RolandThsive/Solder-Fume-Extractor/Documentations/dc_jack.jpg

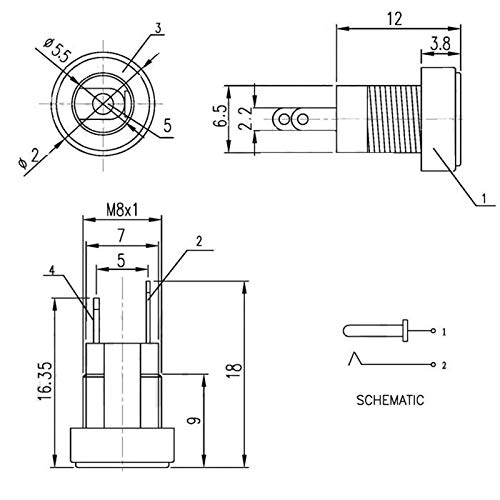
Documentations/dc_jack.jpg
