RolandThsive/Solder-Fume-Extractor/Documentations/dc_jack_5d5_2d5.jpg

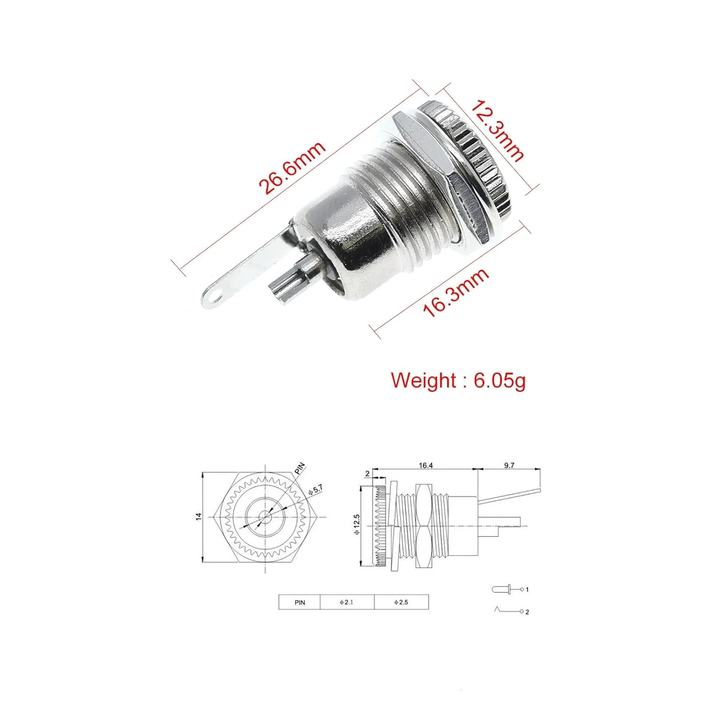
Documentations/dc_jack_5d5_2d5.jpg
