RolandThsive/Solder-Fume-Extractor/Pictures/Showcasing/01_cover.png

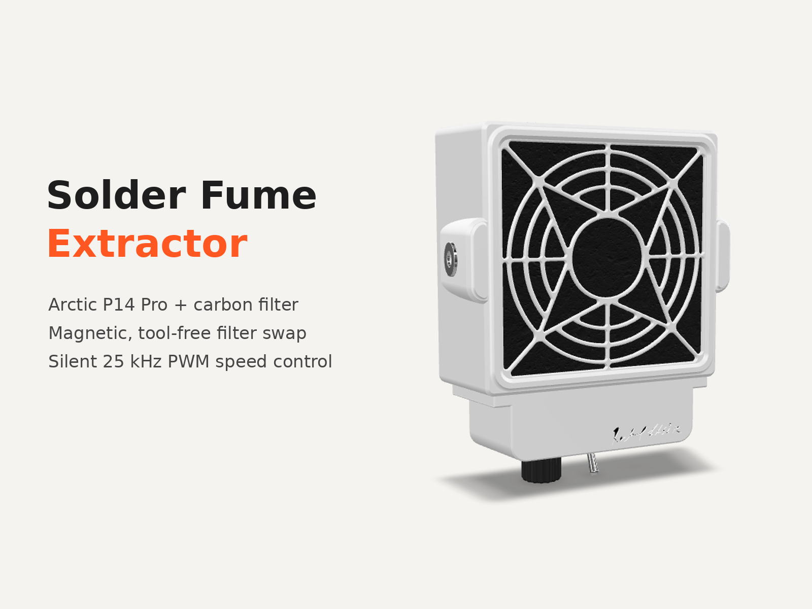
Pictures/Showcasing/01_cover.png
