RolandThsive/Solder-Fume-Extractor/Pictures/Showcasing/01_cover_3x4.png

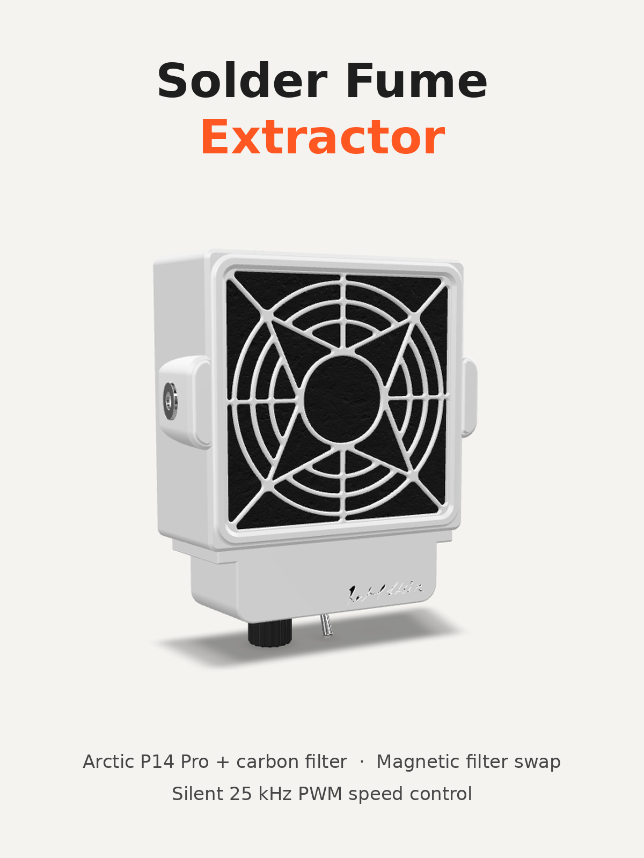
Pictures/Showcasing/01_cover_3x4.png
