RolandThsive/Solder-Fume-Extractor/Pictures/Showcasing/03_main_body.png

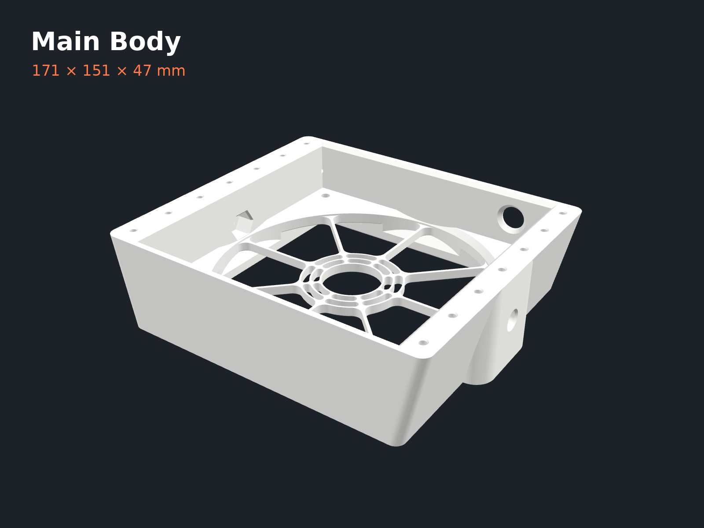
Pictures/Showcasing/03_main_body.png
