RolandThsive/Solder-Fume-Extractor/Pictures/Showcasing/04_back_cover.png

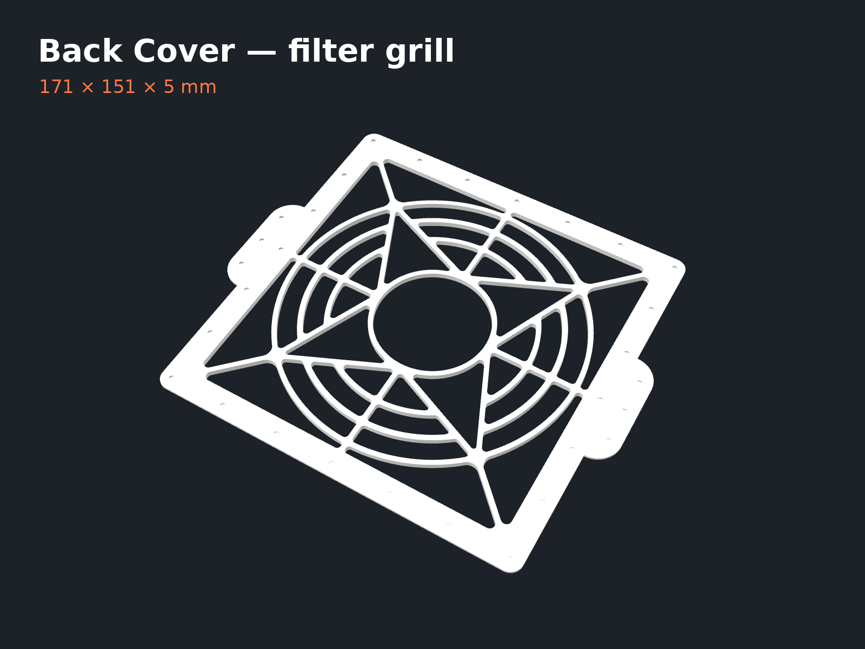
Pictures/Showcasing/04_back_cover.png
