RolandThsive/Solder-Fume-Extractor/Pictures/Showcasing/05_back_plate.png

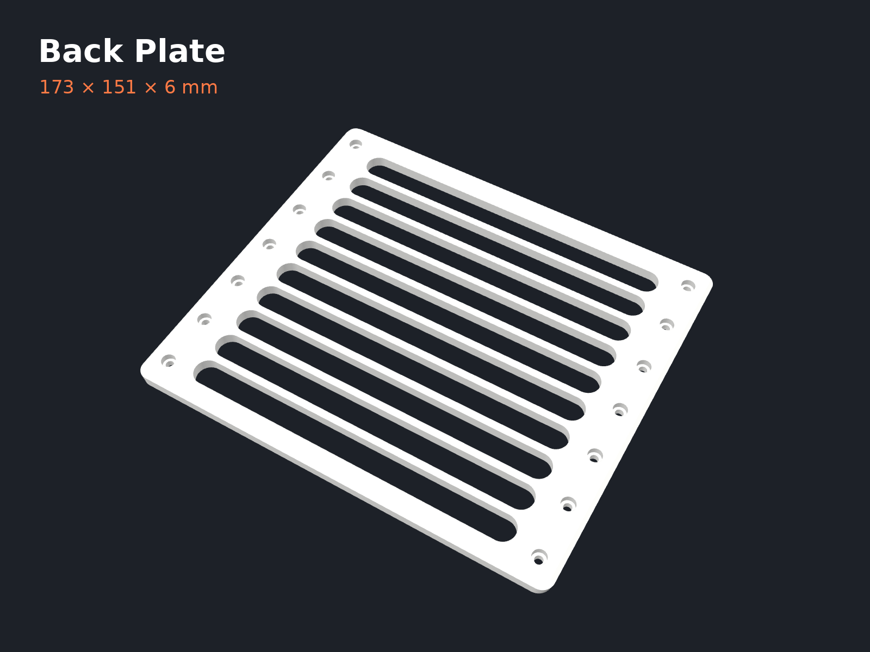
Pictures/Showcasing/05_back_plate.png
