RolandThsive/Solder-Fume-Extractor/Pictures/Showcasing/06_electronics_housing.png

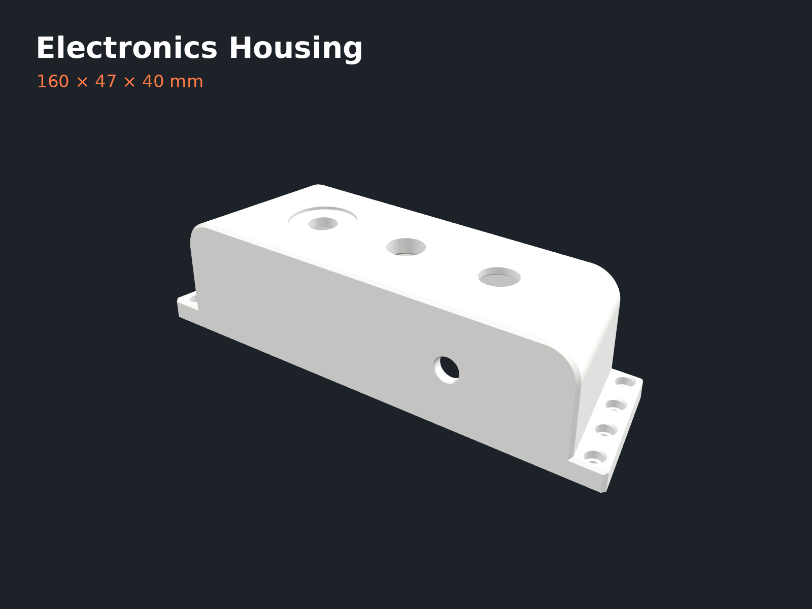
Pictures/Showcasing/06_electronics_housing.png
