RolandThsive/Solder-Fume-Extractor/Pictures/Showcasing/07_pot_knob.png

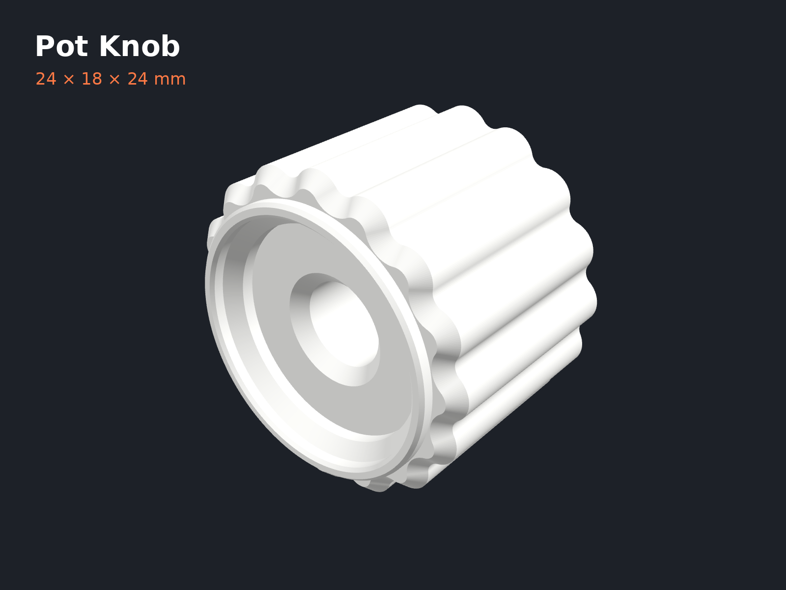
Pictures/Showcasing/07_pot_knob.png
