RolandThsive/Solder-Fume-Extractor/Pictures/Showcasing/08_stand_concept1.png

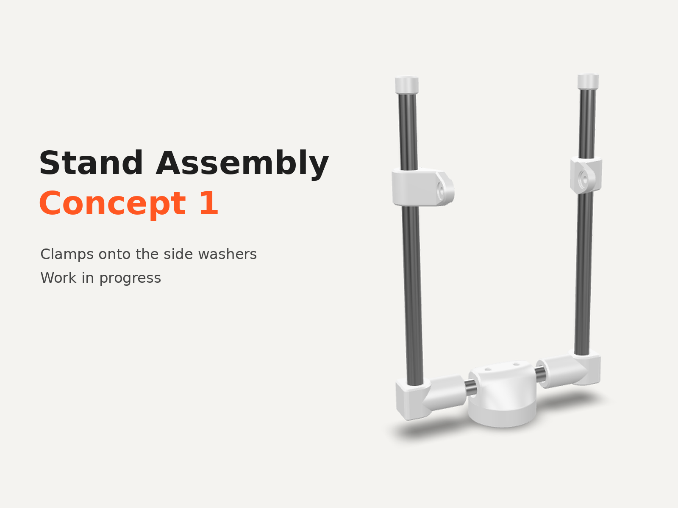
Pictures/Showcasing/08_stand_concept1.png
