RolandThsive/Solder-Fume-Extractor/Pictures/Showcasing/02_parts_overview.png

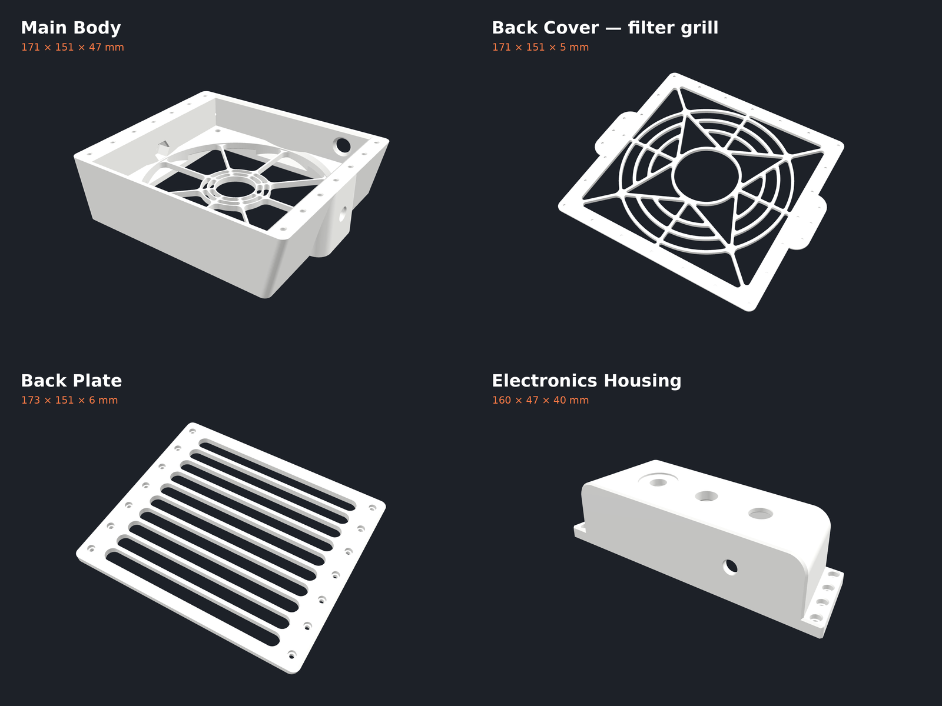
Pictures/Showcasing/02_parts_overview.png
