RolandThsive/Solder-Fume-Extractor/CAD/Solder Fume Extractor CAD/Steps/Solder Fume Extractor Without Stand/Complete Step File/SolderFumeExtractor_completeASM.step

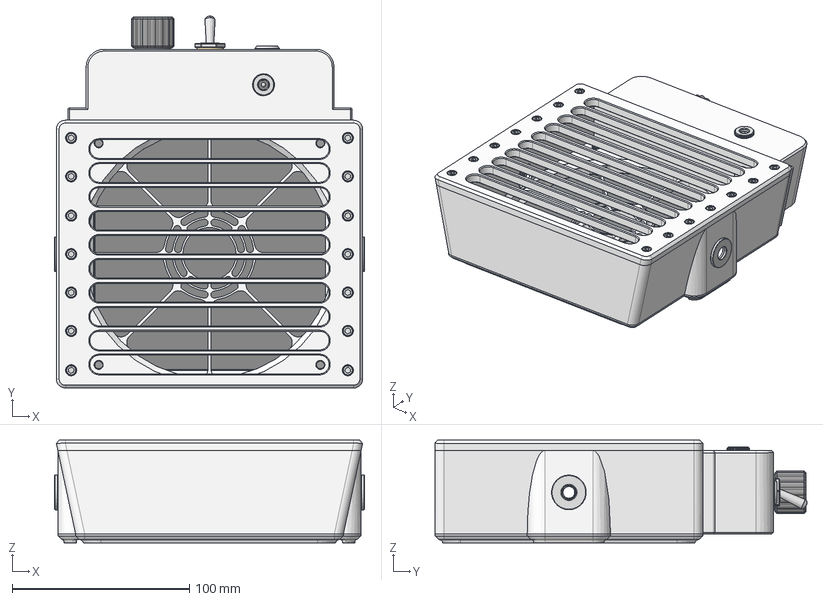
[picture p14: CAD file, 2026-10-24]
CAD/Solder Fume Extractor CAD/Steps/Solder Fume Extractor Without Stand/Complete Step File/SolderFumeExtractor_completeASM.step
175.0 x 209.8 x 58.0 mm
carbon_filter
3_x_10_allen_bolt x 14
back_plate
4mm_1d5_neodynium x 30
back_cover
4mm_4mm_neodynium_magnet x 30
m8_washer x 2
m3_nut x 14
fan_screw x 4
ecrou_m8 x 2
main_body
pot_knob
3_x_8_allen_bolt x 8
washer_12mm
3x5_m3_terminal x 3
m12x0_75_nut
plastic_housing
board
switch_lever
metal_body
the_terminal_pin
top_part_v2
nut_m11x0_75
housing
pin2_1
ring
pin1_2_5_
m10nut
threads
pin3
pin1
shaft
pin2
m10_washer
