RolandThsive/Solder-Fume-Extractor/CAD/Solder Fume Extractor CAD/Steps/Solder Fume Extractor Without Stand/Unique Files/fume_extractor_complete_asm - 4mm_4mm_neodynium_magnet (26).step

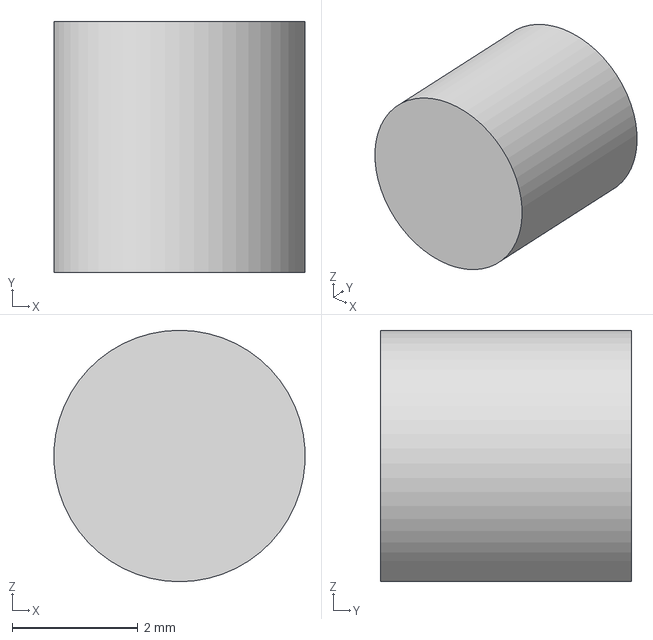
[picture p15: CAD file, 2026-10-24]
CAD/Solder Fume Extractor CAD/Steps/Solder Fume Extractor Without Stand/Unique Files/fume_extractor_complete_asm - 4mm_4mm_neodynium_magnet (26).step
3.99 x 4.00 x 4.00 mm
