RolandThsive/Solder-Fume-Extractor/CAD/Solder Fume Extractor CAD/STLs/main_body.stl

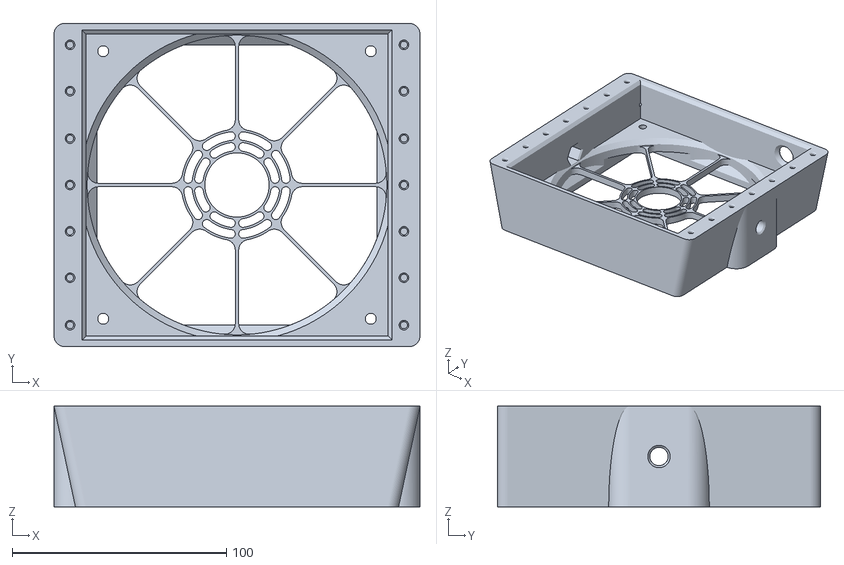
[picture p16: CAD file, 2026-10-24]
CAD/Solder Fume Extractor CAD/STLs/main_body.stl
171.0 x 151.0 x 47.0
