RolandThsive/Solder-Fume-Extractor/CAD/Solder Fume Extractor CAD/Steps/Solder Fume Extractor Without Stand/Unique Files/fume_extractor_complete_asm - 4mm_1d5_neodynium (11).step

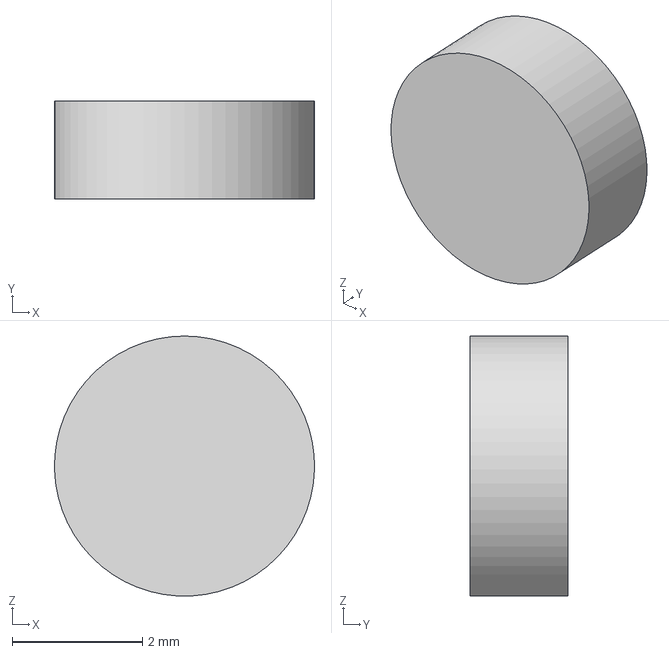
[picture p17: CAD file, 2026-10-24]
CAD/Solder Fume Extractor CAD/Steps/Solder Fume Extractor Without Stand/Unique Files/fume_extractor_complete_asm - 4mm_1d5_neodynium (11).step
4.00 x 1.50 x 4.00 mm
