RolandThsive/Solder-Fume-Extractor/CAD/Solder Fume Extractor CAD/Steps/Solder Fume Extractor Without Stand/Unique Files/fume_extractor_complete_asm - back_plate.step

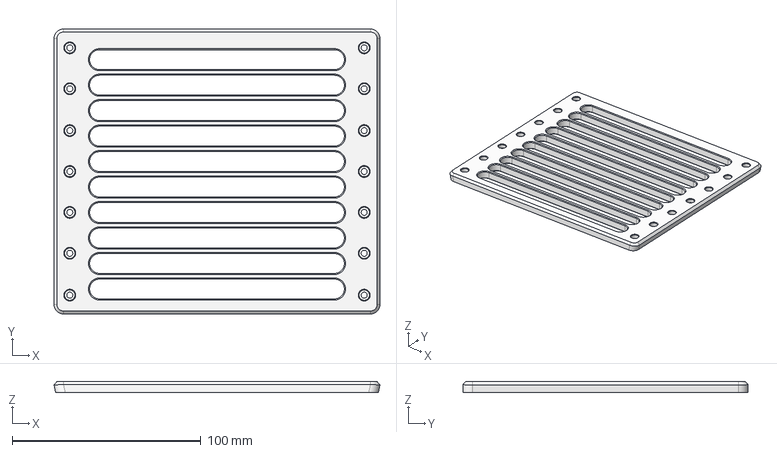
[picture p18: CAD file, 2026-10-24]
CAD/Solder Fume Extractor CAD/Steps/Solder Fume Extractor Without Stand/Unique Files/fume_extractor_complete_asm - back_plate.step
172.7 x 151.0 x 6.00 mm
