RolandThsive/Solder-Fume-Extractor/CAD/Solder Fume Extractor CAD/Steps/Solder Fume Extractor Without Stand/Unique Files/fume_extractor_complete_asm - switch_lever.step

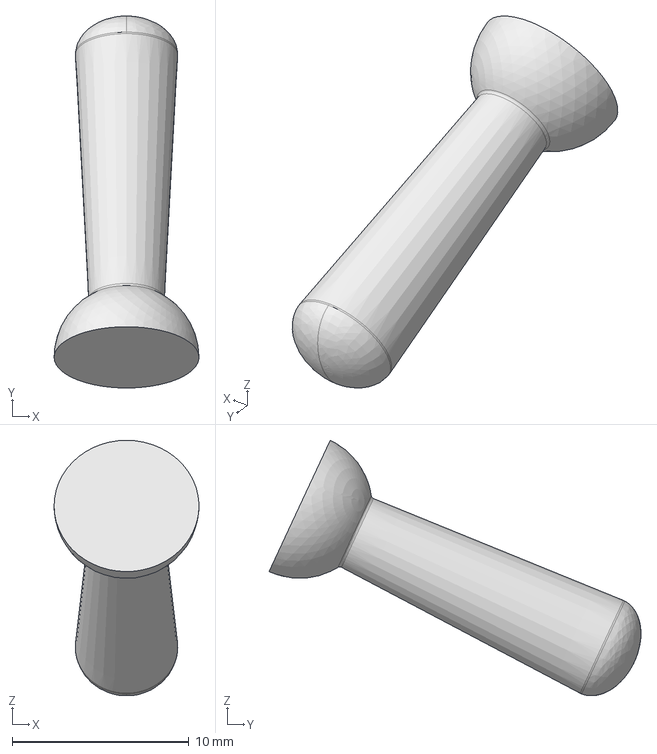
[picture p19: CAD file, 2026-10-24]
CAD/Solder Fume Extractor CAD/Steps/Solder Fume Extractor Without Stand/Unique Files/fume_extractor_complete_asm - switch_lever.step
8.20 x 21.1 x 14.5 mm
