RolandThsive/Solder-Fume-Extractor/CAD/Solder Fume Extractor CAD/Steps/Solder Fume Extractor Without Stand/Unique Files/fume_extractor_complete_asm - body.step

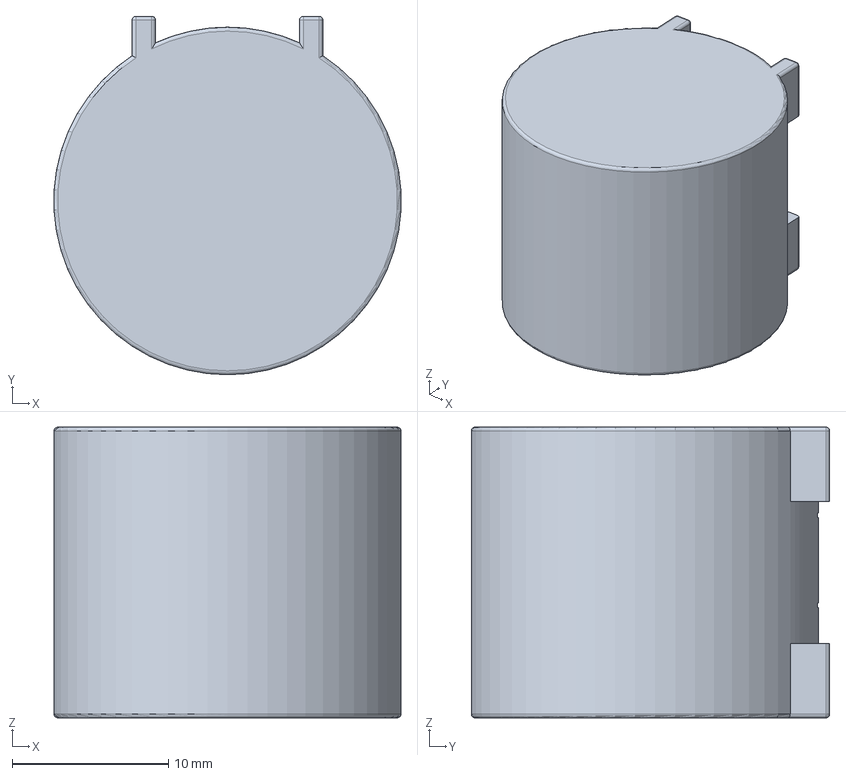
[picture p20: CAD file, 2026-10-24]
CAD/Solder Fume Extractor CAD/Steps/Solder Fume Extractor Without Stand/Unique Files/fume_extractor_complete_asm - body.step
22.2 x 22.9 x 18.6 mm
