RolandThsive/Solder-Fume-Extractor/(list of files, cad)

Other CAD files:
CAD/Solder Fume Extractor CAD/Steps/Solder Fume Extractor Without Stand/Unique Files/fume_extractor_complete_asm - 4mm_4mm_neodynium_magnet (16).step
CAD/Solder Fume Extractor CAD/STLs/Bambu 3MF files/main_body.3mf
CAD/Solder Fume Extractor CAD/Steps/Solder Fume Extractor Without Stand/Unique Files/fume_extractor_complete_asm - 4mm_1d5_neodynium (17).step
CAD/Solder Fume Extractor CAD/Steps/Solder Fume Extractor Without Stand/Unique Files/fume_extractor_complete_asm - 4mm_4mm_neodynium_magnet (21).step
CAD/Solder Fume Extractor CAD/Steps/Solder Fume Extractor Without Stand/Unique Files/fume_extractor_complete_asm - 4mm_1d5_neodynium (29).step
CAD/Solder Fume Extractor CAD/Steps/Solder Fume Extractor Without Stand/Unique Files/fume_extractor_complete_asm - 4mm_4mm_neodynium_magnet.step
CAD/Solder Fume Extractor CAD/Steps/Solder Fume Extractor Without Stand/Unique Files/fume_extractor_complete_asm - 4mm_4mm_neodynium_magnet (28).step
CAD/Solder Fume Extractor CAD/Steps/Solder Fume Extractor Without Stand/Unique Files/fume_extractor_complete_asm - 4mm_4mm_neodynium_magnet (15).step
CAD/Solder Fume Extractor CAD/Steps/Solder Fume Extractor Without Stand/Unique Files/fume_extractor_complete_asm - 4mm_4mm_neodynium_magnet (18).step
CAD/Solder Fume Extractor CAD/Steps/Solder Fume Extractor Without Stand/Unique Files/fume_extractor_complete_asm - 4mm_1d5_neodynium (13).step
CAD/Solder Fume Extractor CAD/Steps/Solder Fume Extractor Without Stand/Unique Files/fume_extractor_complete_asm - 4mm_1d5_neodynium (26).step
CAD/Solder Fume Extractor CAD/Steps/Solder Fume Extractor Without Stand/Unique Files/fume_extractor_complete_asm - 4mm_1d5_neodynium (28).step
CAD/Solder Fume Extractor CAD/Steps/Solder Fume Extractor Without Stand/Unique Files/fume_extractor_complete_asm - 4mm_1d5_neodynium.step
CAD/Solder Fume Extractor CAD/Steps/Solder Fume Extractor Without Stand/Unique Files/fume_extractor_complete_asm - 4mm_4mm_neodynium_magnet (23).step
CAD/Solder Fume Extractor CAD/Steps/Solder Fume Extractor Without Stand/Unique Files/fume_extractor_complete_asm - 4mm_1d5_neodynium (21).step
CAD/Solder Fume Extractor CAD/Steps/Solder Fume Extractor Without Stand/Unique Files/fume_extractor_complete_asm - 4mm_1d5_neodynium (16).step
CAD/Solder Fume Extractor CAD/Steps/Solder Fume Extractor Without Stand/Unique Files/fume_extractor_complete_asm - 4mm_1d5_neodynium (20).step
CAD/Solder Fume Extractor CAD/Steps/Solder Fume Extractor Without Stand/Unique Files/fume_extractor_complete_asm - 4mm_1d5_neodynium (23).step
CAD/Solder Fume Extractor CAD/Steps/Solder Fume Extractor Without Stand/Unique Files/fume_extractor_complete_asm - 4mm_1d5_neodynium (18).step
CAD/Solder Fume Extractor CAD/Steps/Solder Fume Extractor Without Stand/Unique Files/fume_extractor_complete_asm - 4mm_1d5_neodynium (19).step
CAD/Solder Fume Extractor CAD/Steps/Solder Fume Extractor Without Stand/Unique Files/fume_extractor_complete_asm - 4mm_4mm_neodynium_magnet (29).step
CAD/Solder Fume Extractor CAD/Steps/Solder Fume Extractor Without Stand/Unique Files/fume_extractor_complete_asm - 4mm_4mm_neodynium_magnet (27).step
CAD/Solder Fume Extractor CAD/Steps/Solder Fume Extractor Without Stand/Unique Files/fume_extractor_complete_asm - 4mm_1d5_neodynium (25).step
CAD/Solder Fume Extractor CAD/Steps/Solder Fume Extractor Without Stand/Unique Files/fume_extractor_complete_asm - 4mm_4mm_neodynium_magnet (24).step
CAD/Solder Fume Extractor CAD/Steps/Solder Fume Extractor Without Stand/Unique Files/fume_extractor_complete_asm - 4mm_4mm_neodynium_magnet (13).step
CAD/Solder Fume Extractor CAD/Steps/Solder Fume Extractor Without Stand/Unique Files/fume_extractor_complete_asm - 4mm_1d5_neodynium (14).step
CAD/Solder Fume Extractor CAD/Steps/Solder Fume Extractor Without Stand/Unique Files/fume_extractor_complete_asm - 4mm_4mm_neodynium_magnet (22).step
CAD/Solder Fume Extractor CAD/Steps/Solder Fume Extractor Without Stand/Unique Files/fume_extractor_complete_asm - main_body.step
CAD/Solder Fume Extractor CAD/Steps/Solder Fume Extractor Without Stand/Unique Files/fume_extractor_complete_asm - 4mm_4mm_neodynium_magnet (19).step
CAD/Solder Fume Extractor CAD/Steps/Solder Fume Extractor Without Stand/Unique Files/fume_extractor_complete_asm - 4mm_4mm_neodynium_magnet (11).step
CAD/Solder Fume Extractor CAD/Steps/Solder Fume Extractor Without Stand/Unique Files/fume_extractor_complete_asm - pin2.step
CAD/Solder Fume Extractor CAD/Steps/Solder Fume Extractor Without Stand/Unique Files/fume_extractor_complete_asm - 4mm_1d5_neodynium (27).step
CAD/Solder Fume Extractor CAD/Steps/Solder Fume Extractor Without Stand/Unique Files/fume_extractor_complete_asm - 4mm_4mm_neodynium_magnet (14).step
CAD/Solder Fume Extractor CAD/Steps/Solder Fume Extractor Without Stand/Unique Files/fume_extractor_complete_asm - 4mm_1d5_neodynium (22).step
CAD/Solder Fume Extractor CAD/Steps/Solder Fume Extractor Without Stand/Unique Files/fume_extractor_complete_asm - pin3.step
CAD/Solder Fume Extractor CAD/Steps/Solder Fume Extractor Without Stand/Unique Files/fume_extractor_complete_asm - 4mm_4mm_neodynium_magnet (25).step
CAD/Solder Fume Extractor CAD/Steps/Solder Fume Extractor Without Stand/Unique Files/fume_extractor_complete_asm - 4mm_1d5_neodynium (15).step
CAD/Solder Fume Extractor CAD/Steps/Solder Fume Extractor Without Stand/Unique Files/fume_extractor_complete_asm - 4mm_1d5_neodynium (10).step
CAD/Solder Fume Extractor CAD/Steps/Solder Fume Extractor Without Stand/Unique Files/fume_extractor_complete_asm - 4mm_4mm_neodynium_magnet (10).step
CAD/Solder Fume Extractor CAD/Steps/Solder Fume Extractor Without Stand/Unique Files/fume_extractor_complete_asm - 4mm_4mm_neodynium_magnet (20).step
CAD/Solder Fume Extractor CAD/Steps/Solder Fume Extractor Without Stand/Unique Files/fume_extractor_complete_asm - 4mm_1d5_neodynium (24).step
CAD/Solder Fume Extractor CAD/Steps/Solder Fume Extractor Without Stand/Unique Files/fume_extractor_complete_asm - 4mm_1d5_neodynium (12).step
CAD/Solder Fume Extractor CAD/Steps/Solder Fume Extractor Without Stand/Unique Files/fume_extractor_complete_asm - 4mm_4mm_neodynium_magnet (12).step
CAD/Solder Fume Extractor CAD/Steps/Solder Fume Extractor Without Stand/Unique Files/fume_extractor_complete_asm - 4mm_4mm_neodynium_magnet (17).step
CAD/Solder Fume Extractor CAD/STLs/Bambu 3MF files/top_part_v2.3mf
CAD/Solder Fume Extractor CAD/STLs/front_cover.stl
CAD/Solder Fume Extractor CAD/STLs/back_plate.stl
CAD/Solder Fume Extractor CAD/STLs/Bambu 3MF files/front_cover.3mf
CAD/Solder Fume Extractor CAD/STLs/Bambu 3MF files/back_plate.3mf
CAD/Solder Fume Extractor CAD/STLs/pot_knob.stl
CAD/Solder Fume Extractor CAD/STLs/Bambu 3MF files/pot_knob.3mf
CAD/Solder Fume Extractor CAD/STLs/top_part_v2.stl
CAD/Blender Project/Full Assembly Without Stand/SolderFumeExtractor_FullAssembly.blend
CAD/Blender Project/Full_Assembly_Exploded/SolderFumeExtractor_FullAssembly_Exploded.blend
CAD/Blender Project/Stand_Conept1/SFE_Stand_Concep1.blend
CAD/Solder Fume Extractor CAD/STLs/Bambu 3MF files/m3_nut_mask.3mf
CAD/Solder Fume Extractor CAD/STLs/m3_nut_mask.stl
CAD/Solder Fume Extractor CAD/Steps/Solder Fume Extractor Without Stand/Unique Files/fume_extractor_complete_asm - 3_x_10_allen_bolt (1).step
CAD/Solder Fume Extractor CAD/Steps/Solder Fume Extractor Without Stand/Unique Files/fume_extractor_complete_asm - 3_x_10_allen_bolt (10).step
CAD/Solder Fume Extractor CAD/Steps/Solder Fume Extractor Without Stand/Unique Files/fume_extractor_complete_asm - 3_x_10_allen_bolt (11).step
CAD/Solder Fume Extractor CAD/Steps/Solder Fume Extractor Without Stand/Unique Files/fume_extractor_complete_asm - 3_x_10_allen_bolt (12).step
CAD/Solder Fume Extractor CAD/Steps/Solder Fume Extractor Without Stand/Unique Files/fume_extractor_complete_asm - 3_x_10_allen_bolt (13).step
CAD/Solder Fume Extractor CAD/Steps/Solder Fume Extractor Without Stand/Unique Files/fume_extractor_complete_asm - 3_x_10_allen_bolt (2).step
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
