RolandThsive/Solder-Fume-Extractor/Pictures/Real Pictures of Solder Fume Extractor/IMG_20251010_112719320.jpg

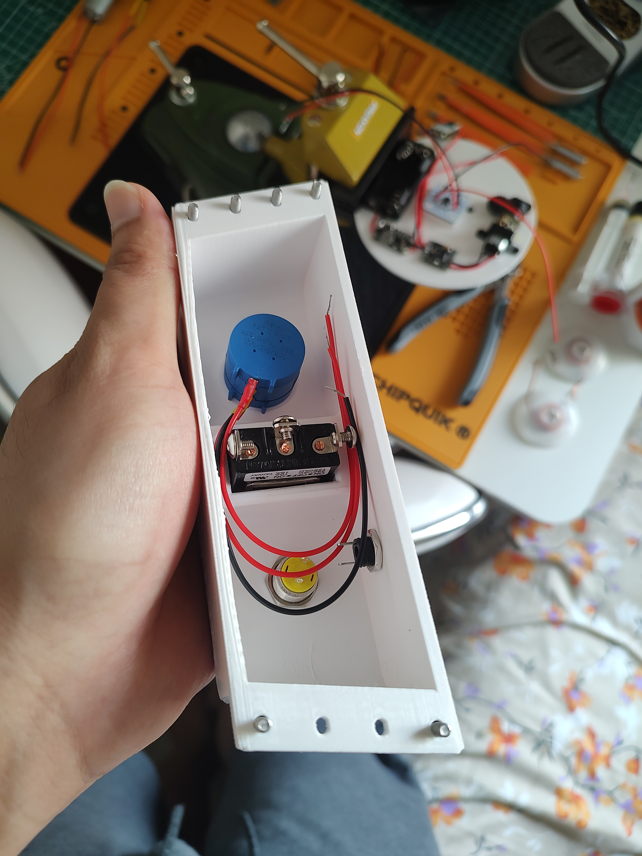
Pictures/Real Pictures of Solder Fume Extractor/IMG_20251010_112719320.jpg
