RolandThsive/Solder-Fume-Extractor/Pictures/Real Pictures of Solder Fume Extractor/IMG_20251010_113705540.jpg

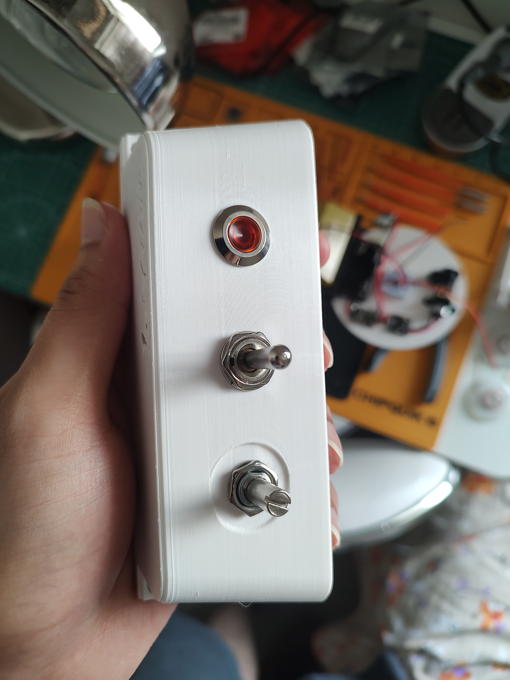
Pictures/Real Pictures of Solder Fume Extractor/IMG_20251010_113705540.jpg
