RolandThsive/Solder-Fume-Extractor/Pictures/Real Pictures of Solder Fume Extractor/IMG_20260515_195002534_HDR.jpg

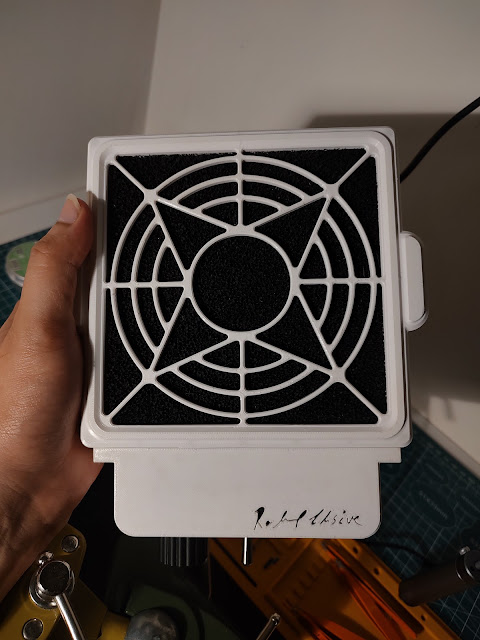
Pictures/Real Pictures of Solder Fume Extractor/IMG_20260515_195002534_HDR.jpg
