RolandThsive/Solder-Fume-Extractor/Pictures/Real Pictures of Solder Fume Extractor/Screenshot_20261025-032223.png

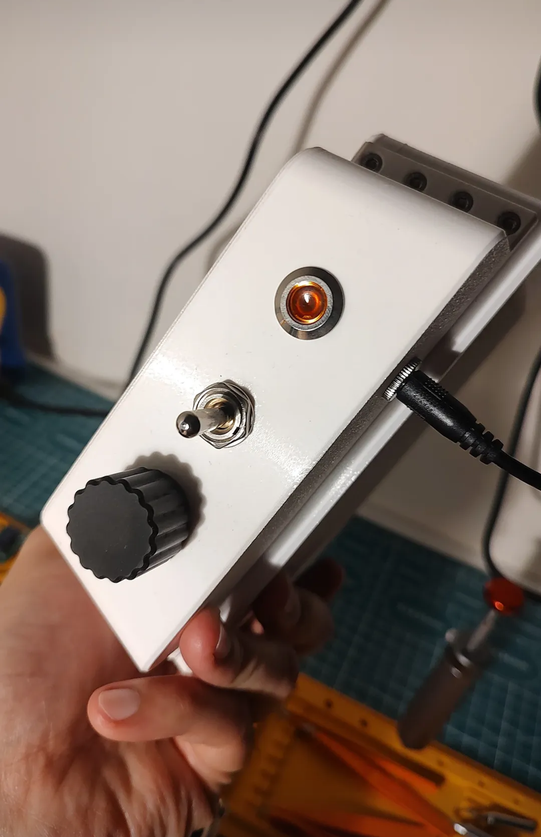
Pictures/Real Pictures of Solder Fume Extractor/Screenshot_20261025-032223.png
