RolandThsive/Solder-Fume-Extractor/Pictures/Real Pictures of Solder Fume Extractor/Screenshot_20261025-032442.png

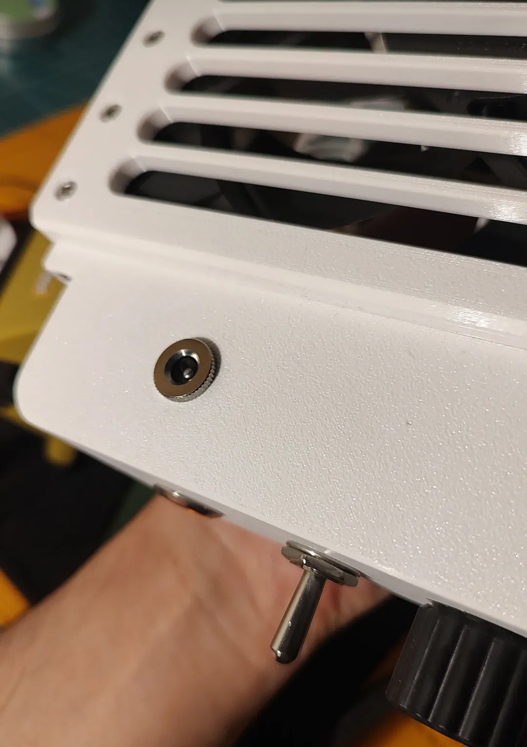
Pictures/Real Pictures of Solder Fume Extractor/Screenshot_20261025-032442.png
