RolandThsive/Solder-Fume-Extractor/(commit log)

2026-10-24 First update
    [4mm_magnet_tester.stl, SFE_Stand_Concep1.blend, SolderFumeExtractor_FullAssembly.blend, SolderFumeExtractor_FullAssembly_Exploded.blend, SolderFumeExtractor_completeASM.step, back_cover.stl, back_plate.stl, fume_extractor_complete_asm - 3_x_10_allen_bolt (1).step]
2026-10-24 good ones
    [back_cover.stl, back_plate.3mf, front_cover.3mf, front_cover.stl, m3_nut_mask.3mf, main_body.3mf, pot_knob.3mf, top_part_v2.3mf]
